Samke004/Mobile-robot-ESP32/README.md

# Mobile-robot-ESP32
Autonomous ESP32 mobile robot (THENCHICK): ultrasonic scanning + PIR target confirmation, real-time WebSocket UI, and ESP32-CAM visual verification. Built for the “Embedded Computer Systems” course (Master’s in Computing).
